jordi-h/sunflower/report/imgs/model2.jpg

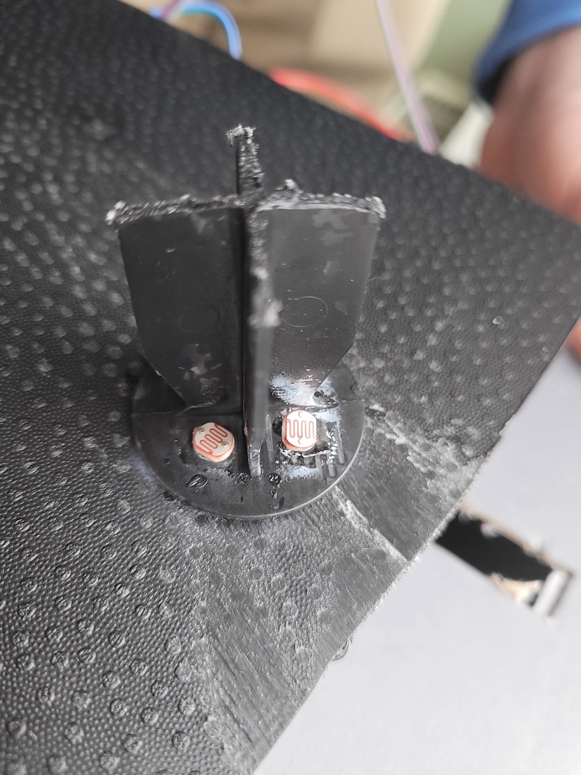
report/imgs/model2.jpg
