jordi-h/sunflower/report/imgs/model3.jpg

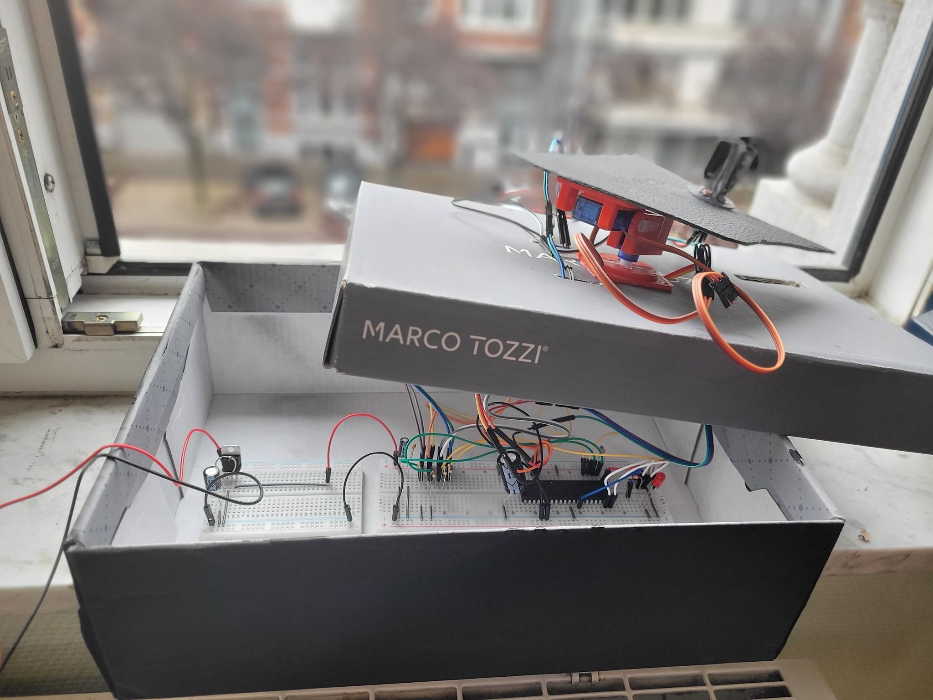
report/imgs/model3.jpg
