jordi-h/sunflower/report/imgs/model4.jpg

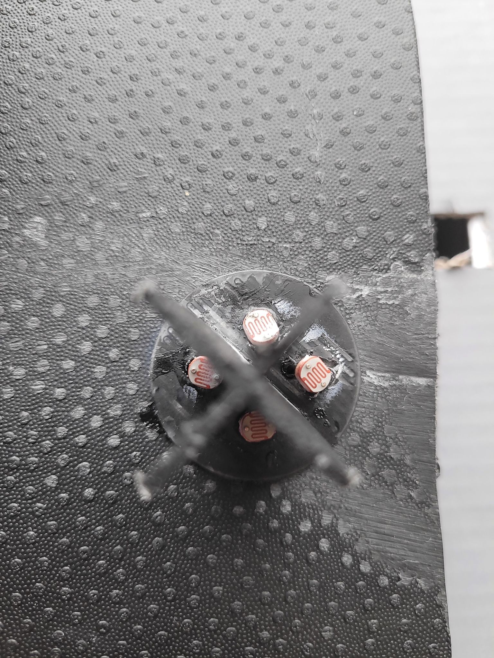
report/imgs/model4.jpg
