jordi-h/sunflower/3dprinter_slt_files/Pan-tilt-plataforma.stl

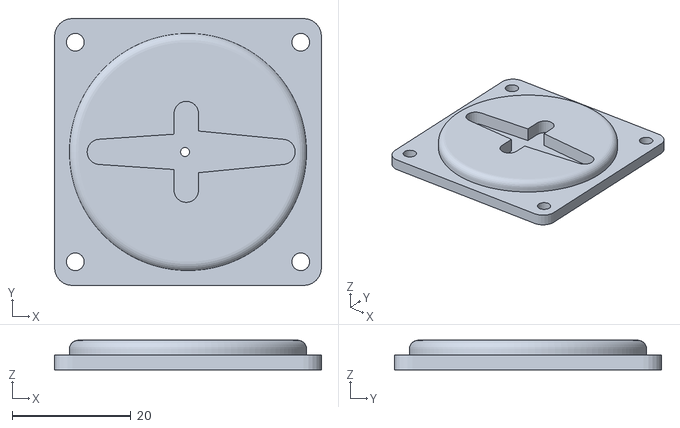
[picture p10: CAD file, 2022-07-13]
3dprinter_slt_files/Pan-tilt-plataforma.stl
45.0 x 45.0 x 5.00
