jordi-h/sunflower/3dprinter_slt_files/Pan-tilt-tapa.stl

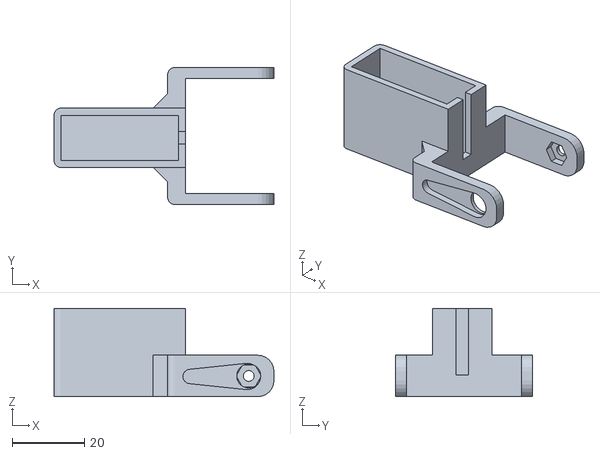
[picture p11: CAD file, 2022-07-13]
3dprinter_slt_files/Pan-tilt-tapa.stl
61.0 x 38.0 x 24.5
