jordi-h/sunflower/3dprinter_slt_files/Pan-tilt-base-camara.stl

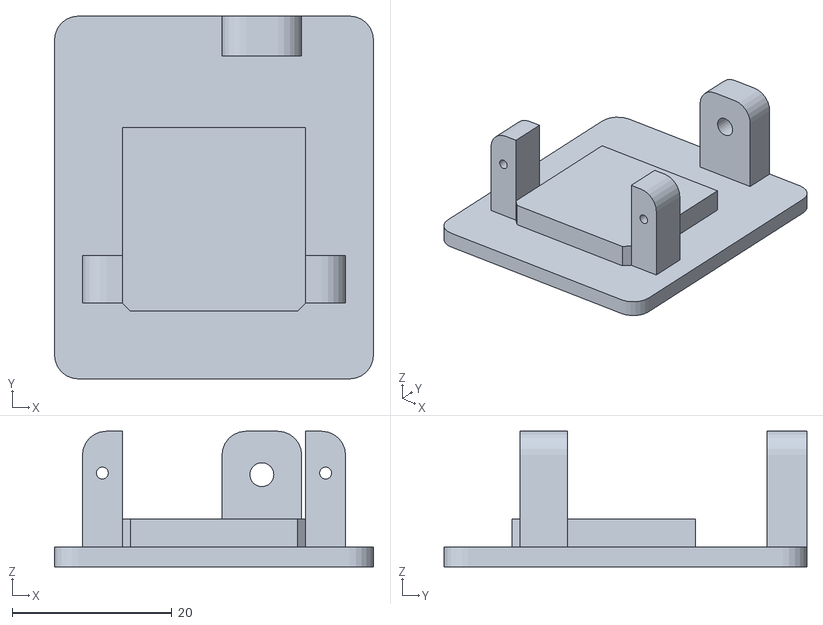
[picture p12: CAD file, 2022-07-13]
3dprinter_slt_files/Pan-tilt-base-camara.stl
40.0 x 45.5 x 17.0
