jordi-h/sunflower/(list of files, cad)

Other CAD files:
kicad/LIB_PIC16F1789-I_P/PIC16F1789-I_P/Allegro/pic16f1789-i_p.psm
kicad/LIB_PIC16F1789-I_P/PIC16F1789-I_P/DEHDL/pic16f1789_i_p/chips/chips.prt
