jordi-h/sunflower/(commit log)

2022-09-24 led on if ldr0 > ldr1, led off otherwise.
2022-09-29 code to show to teacher for pwm
2022-10-02 servo motors first attempt (not working)
    [main.asm]
2022-10-02 include files does not work so must change
    [main.asm]
2022-10-04 ldrs_code works on 2MHz+ADC delay rectification.
2022-10-04 Servo motor goes to initialised position on 2MHz.
2022-10-06 version stable: servo bouge mais probleme servov
    [main.asm]
2022-10-06 SERVO FONCTIONNE 3 VALEURS V1
2022-10-11 Servo 360 works; 180 still to be done
2022-10-11 servo 360 work & servo 180 go right and left
2022-10-11 servo 360 work & servo 180 go right and left.
2022-10-11 booth servos work for the first time
2022-10-11 Servos fonctionnent (capacitor ajouté)
2022-10-11 Kikad updated
    [esp_kicad.kicad_sch]
2022-10-15 Project V1.0
    [esp_kicad.kicad_sch]
